mjlee111/K-robot-opensource/K-robot-circuit-Schematic.pdf

Arduino Nano Module | 9V Power

# UART Debug

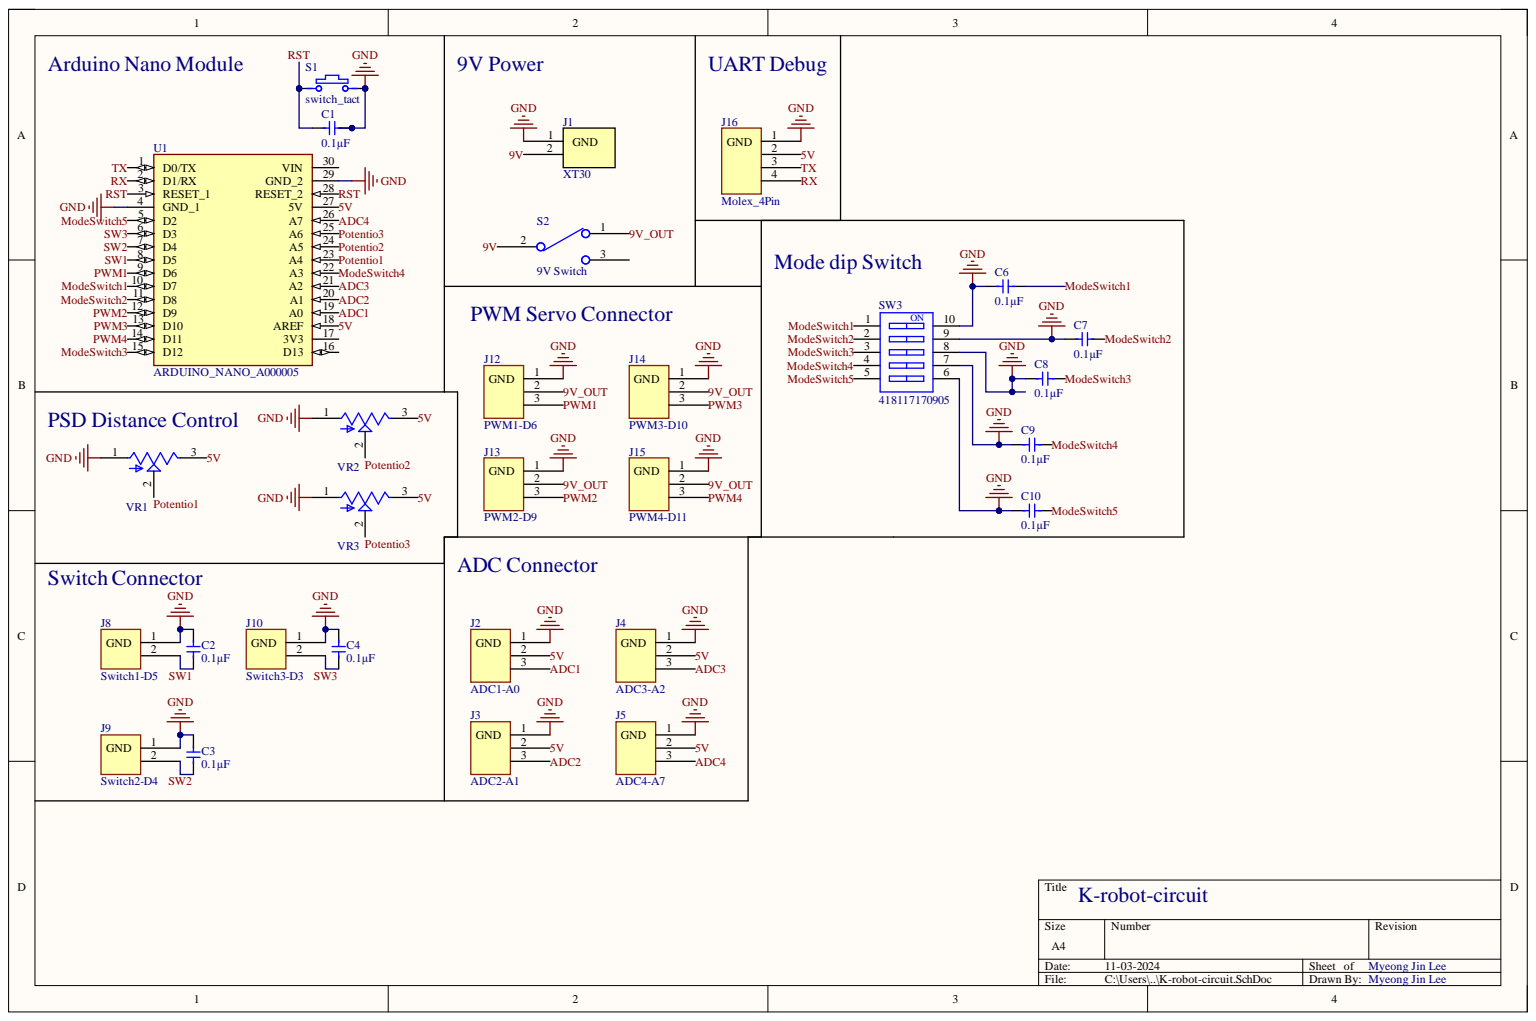
[picture p2: page 1]
