mjlee111/K-robot-opensource/(commit log)

2024-10-30 feat: timer/stopwatch function fin
2024-11-02 feat: add type1 arduino firmware file
2024-11-03 chore: add K-robot-circuit-Schematic file
2024-11-03 fix: change ADC, Mode button pins
2024-11-08 feat: add K-Robot Arduino Firmware
2024-11-08 docs: fix PCB port image name
2024-11-09 fix: adc random value
    [K-Robot.ino]
2024-11-09 docs: add 시립창동청소년센터
2024-11-09 fix: endless start bug
    [K-Robot.ino]
